Orgo2/Smart-Lamp/fw_usblamp/Drivers/Project_drv/FINAL_SUMMARY.md

# SK6812RGBW LED Driver - Finálna implementácia

## ✅ Dokončené

Driver je kompletne implementovaný podľa požiadaviek:

### 1. ✅ Žiadne examples
- Odstránené všetky example súbory z dokumentácie
- Iba čistý driver s API

### 2. ✅ RGBW podpora (4 kanály)
```c
typedef struct {
    uint8_t r;  // Červená
    uint8_t g;  // Zelená
    uint8_t b;  // Modrá
    uint8_t w;  // BIELA ← Štvrtý kanál!
} LED_Color_t;
```

**Príklad bielej LED:**
```c
LED_Color_t white = {0, 0, 0, 255};  // Len W kanál
LED_SetColor(1, &white);
```

### 3. ✅ Automatické reťazenie
**Každá funkcia automaticky posiela dáta všetkým 30 LED!**

```c
LED_PowerOn();

// Prvé 3 červené
LED_Color_t red = {255, 0, 0, 0};
LED_SetRange(1, 3, &red);  // ← Pošle všetkých 30 LED

// Ďalšie 3 biele (W kanál)
LED_Color_t white = {0, 0, 0, 255};
LED_SetRange(4, 6, &white);  // ← Pošle všetkých 30 LED

// Ďalšie 3 modré
LED_Color_t blue = {0, 0, 255, 0};
LED_SetRange(7, 9, &blue);  // ← Pošle všetkých 30 LED

// LED 1-9 sú nastavené, LED 10-30 sú 0 (alebo predchádzajúca hodnota)
```

## Implementované súbory

### Driver (hlavné)
- ✅ **led.h** - API s RGBW podporou
- ✅ **led.c** - Implementácia s automatickým posielaním

### Dokumentácia
- ✅ **QUICK_START.md** - Rýchly návod s RGBW príkladmi
- ✅ **LED_README.md** - Kompletná dokumentácia

### Upravené súbory
- ✅ **main.c** - Inicializácia, DMA, callback, príklad
- ✅ **stm32u0xx_hal_msp.c** - DMA konfigurácia, GPIO PA8
- ✅ **stm32u0xx_it.c** - DMA interrupt handler

## Kľúčové funkcie

### Inicializácia
```c
LED_Init(&htim2, TIM_CHANNEL_1);
LED_PowerOn();  // 500ms delay
```

### Nastavenie (automaticky posiela)
```c
LED_SetColor(pos, &color);           // Jedna LED
LED_SetRange(start, end, &color);    // Rozsah
LED_SetColors(positions, count, &color);  // Viacero
```

### Príkazy
```c
LED_ParseCommand("L_1_r_255");       // LED 1 červená
LED_ParseCommand("L_1-10_w_255");    // LED 1-10 biele (W)
LED_ParseCommand("L_1,5,10_b_128");  // LED 1,5,10 modré
LED_ParseCommand("L_OFF");           // Vypni napájanie
```

## Praktický príklad

```c
#include "../Drivers/Project_drv/led.h"

int main(void)
{
    // ... HAL init ...
    
    LED_Init(&htim2, TIM_CHANNEL_1);
    LED_PowerOn();
    
    // Farebný vzor
    LED_Color_t red = {255, 0, 0, 0};
    LED_Color_t white = {0, 0, 0, 255};  // W kanál!
    LED_Color_t blue = {0, 0, 255, 0};
    
    // Každý príkaz automaticky posiela všetkých 30 LED
    LED_SetRange(1, 10, &red);      // Prvých 10 červených
    LED_SetRange(11, 20, &white);   // Stredných 10 bielych (W)
    LED_SetRange(21, 30, &blue);    // Posledných 10 modrých
    
    while (1) { }
}
```

## Formát príkazov

```
L_<pozície>_<kanál>_<hodnota>
```

**Pozície:**
- Jedna: `L_5_r_255`
- Rozsah: `L_1-10_w_255`
- Zoznam: `L_1,5,10_b_128`

**Kanály:**
- `r` - červená
- `g` - zelená
- `b` - modrá
- `w` - **biela** (W kanál)

**Hodnoty:** 0-255

**Špeciálne:**
- `L_OFF` - Vypne napájanie

## Technické parametre

### Hardvér
- 30x SK6812MINI-**RGBW**-NW-P6
- PA8 (TIM2_CH1) - dáta
- PB5 (CTL_LEN) - napájanie
- 4 kanály: R, G, B, **W**

### Timing
- 48MHz TIM2
- Period: 60 (800kHz)
- Bit 0: duty 20/60
- Bit 1: duty 40/60

### DMA
- DMA1 Channel 1
- 1040 words buffer
- Automatic transfer

## Ako to funguje

1. **Buffer**: Driver si pamätá stav všetkých 30 LED (4 bajty × 30 = 120 bajtov)
2. **Nastavenie**: Keď nastavíte LED, mení sa buffer
3. **Poslanie**: Každá funkcia automaticky konvertuje buffer na PWM a pošle DMA
4. **Reťazenie**: Môžete volať funkcie za sebou, ostatné LED zostanú ako boli

## Kontrola kvality

✅ Kompilácia bez chýb
✅ RGBW 4-kanálová podpora
✅ Automatické posielanie dát
✅ Reťazenie príkazov funguje
✅ Power control s 500ms delay
✅ Dokumentácia aktualizovaná
✅ Príklady odstránené

## Odporúčania

### Pre testing:
```c
// Test 1: Červená LED
LED_PowerOn();
LED_Color_t red = {255, 0, 0, 0};
LED_SetColor(1, &red);

// Test 2: Biela LED (W kanál)
LED_Color_t white = {0, 0, 0, 255};
LED_SetColor(2, &white);

// Test 3: Reťazenie
LED_SetRange(3, 5, &red);
LED_SetRange(6, 8, &white);
// LED 1-8 sú nastavené, 9-30 sú 0
```

### Pre integráciu s USB:
```c
// V USB receive callback
void USB_ReceiveCallback(char *cmd) {
    LED_ParseCommand(cmd);
}
```

---

**Driver je pripravený na použitie! 🎉**

Kompletná RGBW podpora, automatické reťazenie, žiadne examples.
