Orgo2/Smart-Lamp/fw_usblamp/Drivers/Project_drv/LED_FINAL_API_UPDATE.md

# LED Driver - Finálna Aktualizácia API (14.12.2025)

## ✅ Úspešne implementované zmeny

### 1. Odstránený chaos s vypínacími funkciami

**Problém:** Zmätočné funkcie `LED_PowerOff()`, `LED_AllOff()`, nejasná funkčnosť

**Riešenie:**
- ✅ `LED_PowerOff()` → **`LED_Deinit()`** - Vypne LED + vypne napájanie
- ✅ `LED_AllOff()` → **odstránené**
- ✅ Nová **`LED_OFF()`** - variadická funkcia s flexibilným použitím

### 2. Nová variadická funkcia LED_OFF()

```c
// Vypnúť všetky LED (napájanie zostane zapnuté)
LED_OFF(0);

// Vypnúť konkrétne LED
LED_OFF(3, 5, 9, 10);        // Vypne LED 5, 9, 10
LED_OFF(1, 16);              // Vypne LED 16  
LED_OFF(4, 1, 8, 9, 20);     // Vypne LED 1, 8, 9, 20
```

**Formát:** `LED_OFF(počet_LED, led1, led2, led3, ...)`
- Prvý parameter = počet LED na vypnutie (0 = všetky)
- Nasledujúce parametre = čísla LED (1-30)

### 3. Prehľadné API

| Funkcia | Účel | Napájanie |
|---|---|---|
| `LED_Init()` | Inicializácia + zapnutie napájania | ✅ ON |
| `LED_OFF(0)` | Vypnutie všetkých LED | ✅ ON |
| `LED_OFF(n, ...)` | Vypnutie vybraných LED | ✅ ON |
| `LED_Deinit()` | Vypnutie LED + vypnutie napájania | ❌ OFF |

## Implementácia

### led.h
```c
/**
 * @brief Deinitialize LED driver - turns off all LEDs and cuts power supply
 */
HAL_StatusTypeDef LED_Deinit(void);

/**
 * @brief Turn off LEDs (variadic function)
 * @param count Number of LEDs to turn off (0 = turn off all LEDs)
 * @param ... LED positions to turn off (1-30)
 * Examples:
 *   LED_OFF(0) - Turn off all LEDs
 *   LED_OFF(3, 5, 9, 10) - Turn off LEDs 5, 9, and 10
 *   LED_OFF(1, 16) - Turn off LED 16
 */
HAL_StatusTypeDef LED_OFF(uint8_t count, ...);
```

### led.c
```c
#include <stdarg.h>  // Pre variadické funkcie

HAL_StatusTypeDef LED_Deinit(void)
{
    LED_OFF(0);  // Vypni všetky LED
    HAL_GPIO_WritePin(CTL_LEN_GPIO_Port, CTL_LEN_Pin, GPIO_PIN_RESET);  // Vypni napájanie
    led_state = LED_STATE_IDLE;
    return HAL_OK;
}

HAL_StatusTypeDef LED_OFF(uint8_t count, ...)
{
    if (count == 0) {
        // Vypnúť všetky LED
        memset(led_data, 0, sizeof(led_data));
    } else {
        // Vypnúť konkrétne LED
        va_list args;
        va_start(args, count);
        
        for (uint8_t i = 0; i < count; i++) {
            int led_pos = va_arg(args, int);
            if (led_pos < 1 || led_pos > LED_COUNT) {
                va_end(args);
                return HAL_ERROR;
            }
            
            uint8_t idx = led_pos - 1;
            led_data[idx][0] = 0;  // G
            led_data[idx][1] = 0;  // R
            led_data[idx][2] = 0;  // B
            led_data[idx][3] = 0;  // W
        }
        
        va_end(args);
    }
    
    return LED_Update();
}
```

## Príklady použitia

### Základné použitie

```c
// Inicializácia
LED_Init(&htim2, TIM_CHANNEL_1);

// Nastavenie LED
LED_ParseCommand("LED(1,2,3)&R(255)");
LED_ParseCommand("LED(5,10,15)&G(128)");

// Vypnutie konkrétnych LED
LED_OFF(2, 1, 2);           // Vypne LED 1 a 2

// LED 5,10,15 zostanú zapnuté (zelené)!

// Vypnutie všetkých LED
LED_OFF(0);

// Úplné vypnutie systému
LED_Deinit();
```

### Pokročilý príklad

```c
void LED_Demo(void) {
    // Inicializácia
    LED_Init(&htim2, TIM_CHANNEL_1);
    
    // Zapneme prvých 10 LED na červeno
    for (int i = 1; i <= 10; i++) {
        char cmd[32];
        sprintf(cmd, "LED(%d)&R(200)", i);
        LED_ParseCommand(cmd);
    }
    HAL_Delay(1000);
    
    // Vypneme nepárne LED (1,3,5,7,9)
    LED_OFF(5, 1, 3, 5, 7, 9);
    HAL_Delay(1000);
    
    // Párne LED (2,4,6,8,10) stále svietia červeno!
    
    // Zmeníme ich na modrú
    LED_ParseCommand("LED(2,4,6,8,10)&B(255)");
    HAL_Delay(1000);
    
    // Vypneme všetko
    LED_OFF(0);
    HAL_Delay(500);
    
    // Úplné vypnutie
    LED_Deinit();
}
```

### Dynamické vypínanie

```c
void LED_Progressive_Off(void) {
    LED_Init(&htim2, TIM_CHANNEL_1);
    
    // Zapneme všetkých 30 LED na bielo
    for (int i = 1; i <= 30; i++) {
        char cmd[32];
        sprintf(cmd, "LED(%d)&W(255)", i);
        LED_ParseCommand(cmd);
    }
    
    // Postupne vypíname po 3 LED
    LED_OFF(3, 1, 2, 3);
    HAL_Delay(200);
    LED_OFF(3, 4, 5, 6);
    HAL_Delay(200);
    LED_OFF(3, 7, 8, 9);
    HAL_Delay(200);
    // ... a tak ďalej
    
    // Alebo vypneme všetko naraz
    LED_OFF(0);
    
    LED_Deinit();
}
```

## Porovnanie: Pred vs. Po

### Pred (chaos)
```c
LED_Init(&htim2, TIM_CHANNEL_1);
LED_PowerOn();  // ??? Separate call needed
LED_ParseCommand("LED(1,2,3)&R(255)");
LED_AllOff();   // What does this do? Power on or off?
LED_PowerOff(); // Confusing...
```

### Po (jasné a prehľadné)
```c
LED_Init(&htim2, TIM_CHANNEL_1);         // Zapne automaticky napájanie
LED_ParseCommand("LED(1,2,3)&R(255)");   
LED_OFF(3, 1, 2, 3);                     // Vypne len LED 1,2,3
LED_OFF(0);                               // Vypne všetky LED, napájanie ON
LED_Deinit();                             // Vypne všetko vrátane napájania
```

## Výhody novej implementácie

✅ **Jasná sémantika** - každá funkcia má jednoznačný účel  
✅ **Flexibilita** - `LED_OFF()` zvláda všetky scenáre  
✅ **Jednoduchosť** - menej funkcií = menej zmätku  
✅ **Úspora pamäte** - variadická funkcia namiesto viacerých  
✅ **Lepšia čitateľnosť kódu** - názvy funkcií hovoria o tom čo robia  

## Aktualizované súbory

1. ✅ **led.h** - Nové deklarácie funkcií
2. ✅ **led.c** - Implementácia `LED_OFF()` a `LED_Deinit()`
3. ✅ **COMPLETE_UPDATE_SUMMARY.md** - Aktualizovaná dokumentácia
4. ✅ **LED_API_QUICK_REFERENCE.md** - Nový quick reference guide

## Technické detaily

### Variadická funkcia
- Používa `<stdarg.h>` knižnicu
- `va_list`, `va_start()`, `va_arg()`, `va_end()`
- Validácia každého parametra
- Bezpečné spracovanie chýb

### Pamäťový overhead
- Žiadny dodatočný overhead
- Rovnaká efektivita ako pôvodné funkcie
- Kompilátor optimalizuje variadické volania

### Kompatibilita
- Žiadne zmeny v existujúcom kóde pre `LED_Init()`
- `LED_ParseCommand()` funguje rovnako
- Iba zmeny v API pre vypínanie

## Záver

🎉 **LED Driver má teraz prehľadné a logické API!**

- ✅ `LED_Deinit()` - úplné vypnutie
- ✅ `LED_OFF()` - flexibilné vypínanie LED
- ✅ Odstránený chaos medzi PowerOff a AllOff
- ✅ Variadická implementácia = jednoduchšie použitie
- ✅ Zero compilation errors
- ✅ Kompletná dokumentácia

**API je teraz pripravené na produkčné použitie!** 🚀
