Orgo2/Smart-Lamp/fw_usblamp/Drivers/Project_drv/LED_UPDATE_SUMMARY.md

# LED Driver Update Summary - 2025-12-13

## Changes Implemented

### 1. Merged LED_Init() and LED_PowerOn()
**Problem:** It made no sense to initialize the driver when LED power was off.

**Solution:** 
- `LED_Init()` now automatically turns on the LED power supply
- Waits 500ms for power stabilization
- Clears all LEDs to initial state
- Removed separate `LED_PowerOn()` function

**Before:**
```c
LED_Init(&htim2, TIM_CHANNEL_1);
LED_PowerOn();  // Separate call needed
```

**After:**
```c
LED_Init(&htim2, TIM_CHANNEL_1);  // Power on included!
```

### 2. New Intuitive Command Format
**Problem:** Old format was not user-friendly and didn't support multiple operations easily.

**Solution:** New format: `LED(led_numbers)&COLOR(intensity)`

**Supported Commands:**
1. **Set color and intensity:** `LED(1,5,10)&R(100)`
   - Sets LEDs 1, 5, and 10 to Red with intensity 100
   - Supports R, G, B, W channels
   - Intensity range: 0-255

2. **Turn off specific LEDs:** `LED(1,8,9)&OFF`
   - Turns off LEDs 1, 8, and 9
   - Other LEDs maintain their state

3. **Turn off all LEDs:** `LED(OFF)`
   - Turns off all LEDs
   - Keeps power supply running

### 3. State Management
**Problem:** Driver needed to remember LED states and only update specified LEDs while sending data to all LEDs per datasheet.

**Solution:**
- Driver maintains internal state buffer for all 30 LEDs
- Each command only modifies specified LEDs
- All other LEDs retain their previous state
- Always sends complete data to all 30 LEDs (SK6812RGBW datasheet requirement)

**Example:**
```c
LED_ParseCommand("LED(1)&R(255)");      // LED 1 is Red
LED_ParseCommand("LED(5)&G(128)");      // LED 5 is Green, LED 1 still Red
LED_ParseCommand("LED(10)&B(200)");     // LED 10 is Blue, LEDs 1 and 5 unchanged
LED_ParseCommand("LED(1)&OFF");         // LED 1 off, LEDs 5 and 10 unchanged
```

### 4. Simplified API
**Removed functions:**
- `LED_PowerOn()` - merged into `LED_Init()`
- `LED_SetColor()` - replaced by `LED_ParseCommand()`
- `LED_SetColors()` - replaced by `LED_ParseCommand()`
- `LED_SetRange()` - replaced by `LED_ParseCommand()`
- `LED_Update()` - now private, called automatically

**Kept functions:**
- `LED_Init()` - Enhanced with power on
- `LED_PowerOff()` - Turns off power completely
- `LED_ParseCommand()` - Main interface, new format
- `LED_AllOff()` - Quick clear all LEDs
- `LED_GetState()` - Get driver state
- `LED_TIM_PulseFinishedCallback()` - DMA callback

## Technical Details

### Memory Layout
```c
static uint8_t led_data[LED_COUNT][LED_DATA_SIZE];  // [30 LEDs][G,R,B,W]
```
- Maintains state for all 30 LEDs
- Each LED: 4 bytes (Green, Red, Blue, White)
- Order: GRBW (per SK6812RGBW datasheet)

### Command Parsing
The parser:
1. Validates command format
2. Extracts LED positions (1-30)
3. Extracts color channel and intensity
4. Updates only specified LEDs in state buffer
5. Sends complete buffer to all 30 LEDs via DMA

### Data Transmission
- Uses PWM with DMA
- Sends data to all 30 LEDs every time
- Complies with SK6812RGBW timing requirements
- Reset pulse included automatically

## Usage Examples

### Basic Initialization
```c
// In main.c
LED_Init(&htim2, TIM_CHANNEL_1);
```

### Setting Colors
```c
// Single LED
LED_ParseCommand("LED(1)&R(255)");

// Multiple LEDs same color
LED_ParseCommand("LED(1,5,10,15)&G(128)");

// Different commands for different LEDs
LED_ParseCommand("LED(2,4,6)&B(200)");
LED_ParseCommand("LED(3,5,7)&W(150)");
```

### Turning Off LEDs
```c
// Turn off specific LEDs
LED_ParseCommand("LED(1,2,3)&OFF");

// Turn off all LEDs (keep power on)
LED_ParseCommand("LED(OFF)");

// Turn off power completely
LED_PowerOff();
```

### Dynamic Color Control
```c
char cmd[32];
for (int i = 0; i <= 255; i += 10) {
    sprintf(cmd, "LED(1,2,3,4,5)&R(%d)", i);
    LED_ParseCommand(cmd);
    HAL_Delay(50);
}
```

## Benefits

1. **Simpler Initialization**: One function call instead of two
2. **Intuitive Commands**: Clear, readable format
3. **State Preservation**: LEDs remember their settings
4. **Flexible Control**: Set individual or multiple LEDs
5. **Datasheet Compliance**: Always sends complete data set
6. **Easy Integration**: Simple string-based commands perfect for USB/UART control

## Files Modified

1. **led.h**
   - Updated API documentation
   - Removed obsolete function declarations
   - Added new command format documentation

2. **led.c**
   - Merged `LED_Init()` and `LED_PowerOn()`
   - Completely rewrote `LED_ParseCommand()`
   - Removed `LED_SetColor()`, `LED_SetColors()`, `LED_SetRange()`
   - Made `LED_Update()` private (static)

## Documentation Created

1. **LED_COMMAND_FORMAT.md** - Complete user guide with examples

## Testing Recommendations

Test the following scenarios:

1. **Basic Operations:**
   ```c
   LED_ParseCommand("LED(1)&R(255)");     // Single LED
   LED_ParseCommand("LED(1,5,10)&G(128)"); // Multiple LEDs
   LED_ParseCommand("LED(1)&OFF");         // Turn off one
   LED_ParseCommand("LED(OFF)");           // Turn off all
   ```

2. **State Preservation:**
   ```c
   LED_ParseCommand("LED(1)&R(255)");
   LED_ParseCommand("LED(2)&G(255)");
   // Verify LED 1 is still Red and LED 2 is Green
   ```

3. **Color Mixing:**
   ```c
   LED_ParseCommand("LED(1)&R(100)");
   LED_ParseCommand("LED(1)&G(100)");
   LED_ParseCommand("LED(1)&B(100)");
   // LED 1 should show mixed color (RGB)
   ```

4. **Power Management:**
   ```c
   LED_Init(&htim2, TIM_CHANNEL_1);    // Power on
   LED_ParseCommand("LED(1,2,3)&W(255)");
   LED_PowerOff();                      // Power off
   ```

5. **Error Handling:**
   ```c
   // Test invalid commands
   LED_ParseCommand("LED(50)&R(100)");   // LED 50 doesn't exist
   LED_ParseCommand("LED(1)&X(100)");    // Invalid color
   LED_ParseCommand("LED(1)&R(300)");    // Intensity > 255
   ```

## Migration Guide for Existing Code

If you have existing code using the old API:

**Old Code:**
```c
LED_Init(&htim2, TIM_CHANNEL_1);
LED_PowerOn();

LED_Color_t red = {255, 0, 0, 0};
LED_SetColor(1, &red);

uint8_t positions[] = {5, 10, 15};
LED_SetColors(positions, 3, &red);
```

**New Code:**
```c
LED_Init(&htim2, TIM_CHANNEL_1);  // Power on automatic

LED_ParseCommand("LED(1)&R(255)");
LED_ParseCommand("LED(5,10,15)&R(255)");
```

## Notes

- All LEDs are numbered 1-30 (not 0-29)
- Commands are case-insensitive for color (R/r, G/g, B/b, W/w)
- Driver handles all DMA and timing automatically
- Always check return values for error handling
- Power stabilization delay (500ms) is handled in `LED_Init()`
