Orgo2/Smart-Lamp/suciastky/mic/cmm4030/BOM.txt

3DX_Same_Sky_Supplier: Same Sky
3DX_Same_Sky_Description: 4 x 3 mm, Digital, Top Port, Surface Mount, -26 ±1 dB, MEMS Microphone
3DX_Same_Sky_Model Number: CMM-4030DT-261280-TR
