Orgo2/Smart-Lamp/suciastky/batt/2460.STEP

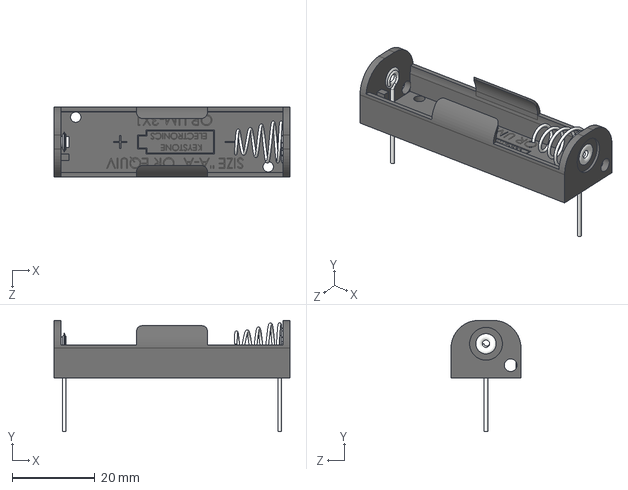
[picture p1: CAD file, 2026-01-05]
suciastky/batt/2460.STEP
57.0 x 26.9 x 16.9 mm
