Orgo2/Smart-Lamp/suciastky/mic/cmm4030/CMM-4030DT-261280-TR.step

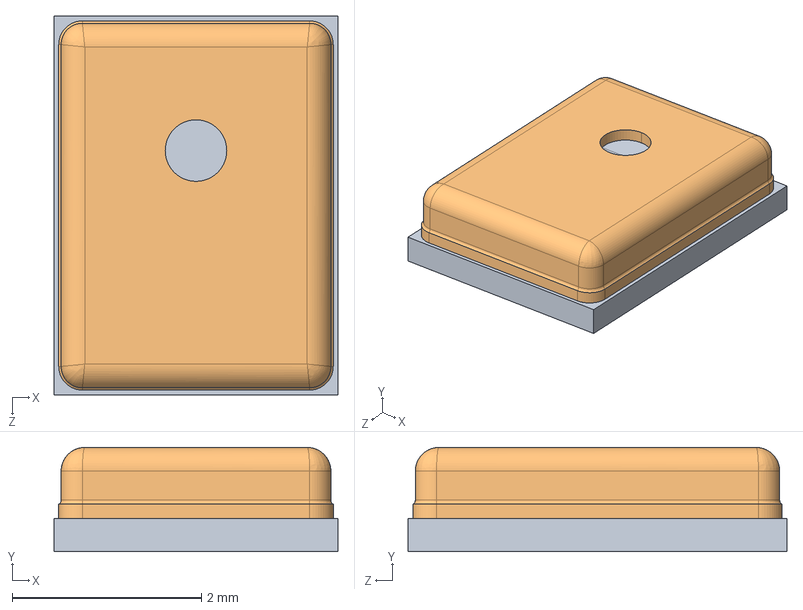
[picture p2: CAD file, 2026-01-05]
suciastky/mic/cmm4030/CMM-4030DT-261280-TR.step
3.00 x 1.10 x 4.00 mm
