Orgo2/Smart-Lamp/suciastky/led/80545_VLMRGB6122-B00_3D_Model.stp

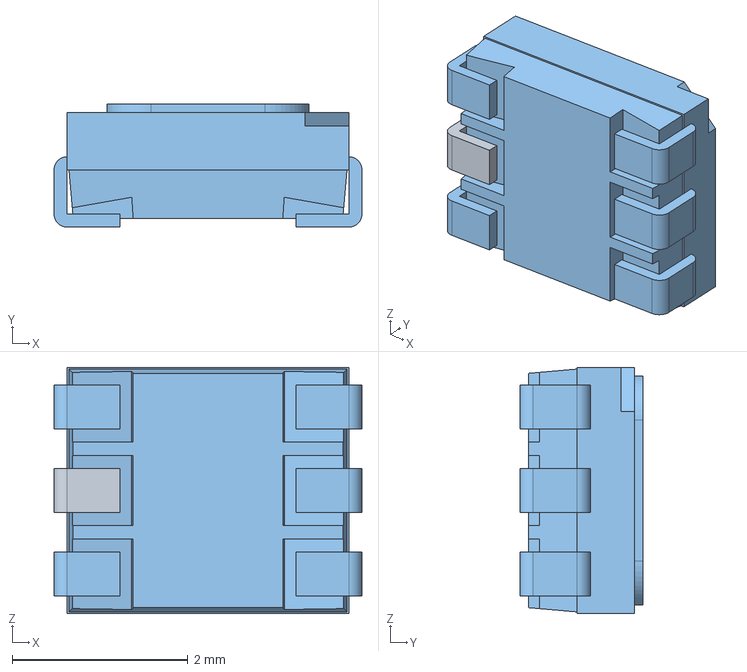
[picture p3: CAD file, 2026-01-05]
suciastky/led/80545_VLMRGB6122-B00_3D_Model.stp
3.50 x 1.40 x 2.80 mm
