Orgo2/Smart-Lamp/lampa_stevko/lampa_stevko.kicad_pcb

## KiCad design lampa_stevko/lampa_stevko.kicad_pcb (2026-01-05)

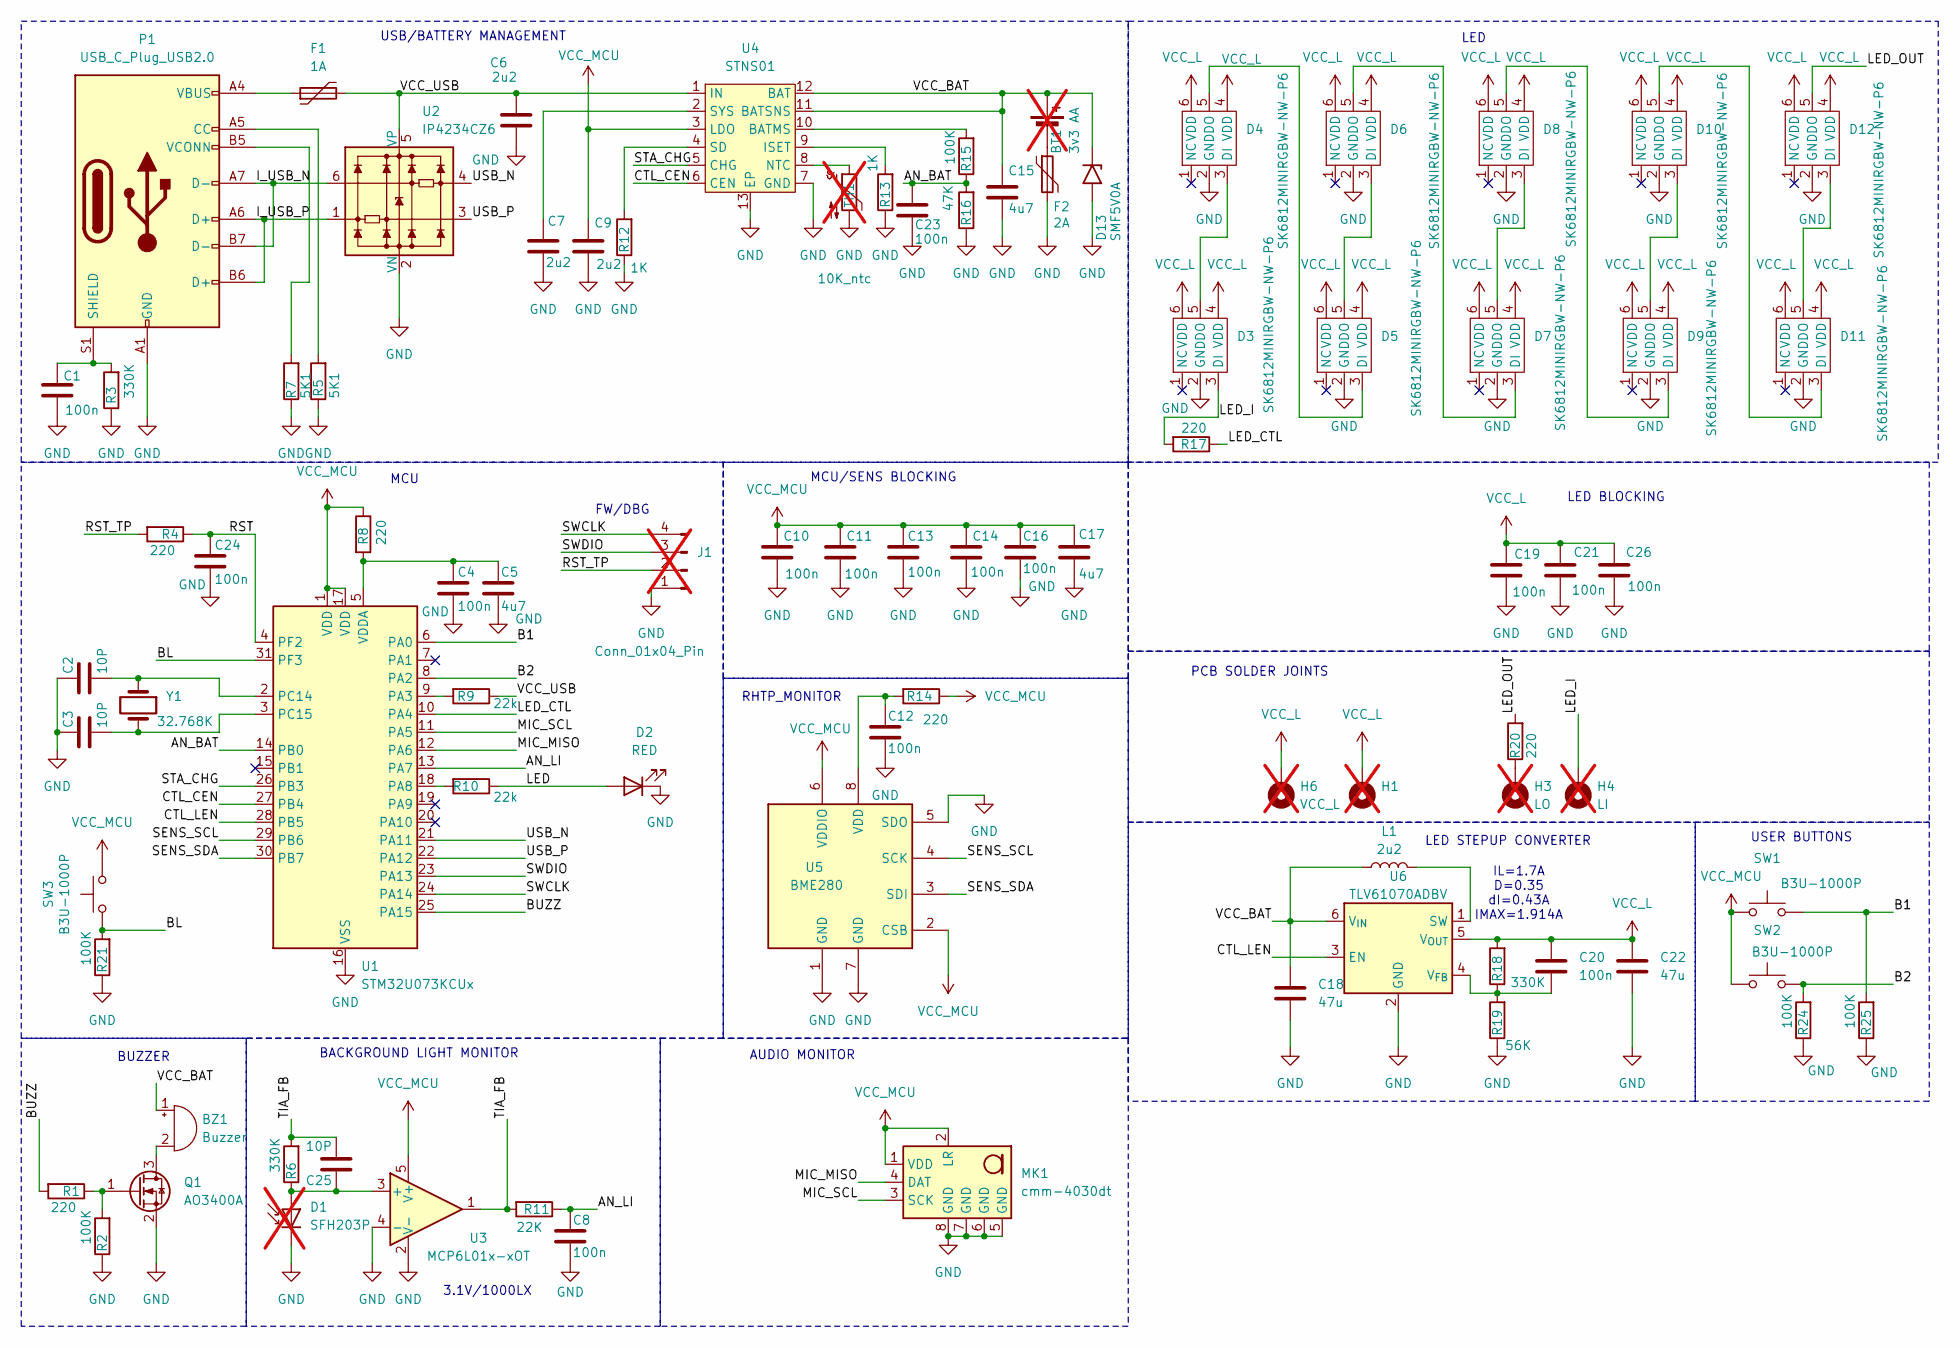
[picture p4: schematic lampa_stevko.kicad_sch]

Parts:
BT1: 3v3 AA; BatteryHolder_Keystone_2460_1xAA; MPN 2460; LCSC C5370863; not fitted
BZ1: Buzzer; Buzzer_CUI_CPT-9019S-SMT; MPN CPT-9019S-SMT-TR; LCSC C95163
C1, C4, C8, C10, C11, C12, C13, C14, C16, C19, C20, C21, C23, C24, C26: 100n; C_0603_1608Metric; MPN CL10B104KO8NNNC; LCSC C66501
C2, C3, C25: 10P; C_0603_1608Metric; MPN CC0603JRNPO8BN100; LCSC C1853175
C5, C15, C17: 4u7; C_0603_1608Metric; MPN CL10A475KP8NNNC; LCSC C1705
C6, C7, C9: 2u2; C_0603_1608Metric; MPN CL10A225KP8NNNC; LCSC C1607
C18, C22: 47u; C_1206_3216Metric; MPN GRM31CR61A476ME15L; LCSC C94034
D1: SFH203P; LED_D3.0mm_Horizontal_O1.27mm_Z6.0mm; MPN SFH 203 P; not fitted
D2: RED; LED_0603_1608Metric; MPN APTD1608LSURCK; LCSC C5342734
D3, D4, D5, D6, D7, D8, D9, D10, D11, D12: SK6812MINIRGBW-NW-P6; LED_RGB_PLCC-6; MPN SK6812MINIRGBW-NW-P6; LCSC C7423107
D13: SMF5V0A; D_SMF; MPN SMF5V0A-E3-08; LCSC C1972946
F1: 1A; R_0603_1608Metric; MPN 0603L100/12AR; LCSC C33977641
F2: 2A; R_0603_1608Metric; MPN JK-SMD0603-200L; LCSC C720073
H1, H6: VCC_L; TestPoint_Pad_2.5x2.5mm; not fitted
H3: LO; TestPoint_Pad_2.5x2.5mm; not fitted
H4: LI; TestPoint_Pad_2.5x2.5mm; not fitted
J1: Conn_01x04_Pin; PinHeader_1x04_P2.54mm_Vertical; not fitted
L1: 2u2; L_1210_3225Metric; MPN DFE322520F-2R2M=P2; LCSC C6021483
MK1: cmm-4030dt; MIC_CMM-4030DT-261280-TR; MPN CMM-4030DT-261075-TR
P1: USB_C_Plug_USB2.0; USB_C_Receptacle_G-Switch_GT-USB-7051x; MPN GT-USB-7051A; LCSC C2843970
Q1: AO3400A; SOT-23; MPN AO3400A; LCSC C49195711
R1, R4, R8, R14, R17, R20: 220; R_0603_1608Metric; MPN RC0603FR-07220RL; LCSC C107696
R2, R15, R21, R24, R25: 100K; R_0603_1608Metric; MPN RC0603FR-07100KL; LCSC C14675
R3, R6, R18: 330K; R_0603_1608Metric; MPN RC0603FR-07330KL; LCSC C114618
R5, R7: 5K1; R_0603_1608Metric; MPN RC0603FR-075K1L; LCSC C105580
R9, R10: 22k; R_0603_1608Metric; MPN RC0603FR-0722KL; LCSC C114065
R11: 22K; R_0603_1608Metric; MPN RC0603FR-0722KL; LCSC C114065
R12, R13: 1K; R_0603_1608Metric; MPN RC0603FR-071KL; LCSC C22548
R16: 47K; R_0603_1608Metric; MPN RC0603FR-0747KL; LCSC C105579
R19: 56K; R_0603_1608Metric; MPN RC0603FR-0756KL; LCSC C114630
SW1, SW2, SW3: B3U-1000P; SW_SPST_B3U-1000P; MPN B3U-1000P; LCSC C231329
TH1: 10K_ntc; R_0603_1608Metric; MPN TH05-3H103F; not fitted
U1: STM32U073KCUx; QFN-32-1EP_5x5mm_P0.5mm_EP3.45x3.45mm; MPN STM32U073KCU6; LCSC C22445363
U2: IP4234CZ6; SC-74-6_1.55x2.9mm_P0.95mm; MPN IP4234CZ6,125; LCSC C455086
U3: MCP6L01x-xOT; SOT-23-5; MPN MCP6L01T-E/OT; LCSC C145745
U4: STNS01; DFN-12-1EP_3x3mm_P0.45mm_EP1.65x2.38mm_ThermalVias; MPN STNS01PUR; LCSC C2848343
U5: BME280; Bosch_LGA-8_2.5x2.5mm_P0.65mm_ClockwisePinNumbering; MPN BME280; LCSC C92489
U6: TLV61070ADBV; SOT-23-6; MPN TLV61070ADBVR; LCSC C6881375
Y1: 32.768K; Crystal_SMD_2012-2Pin_2.0x1.2mm; MPN SC-20S,32.768kHz,20PPM,9pF; LCSC C97603

Connections:
/AN_BAT: C23.1, R15.1, R16.2, U1.14 (PB0)
/AN_LI: C8.1, R11.1, U1.13 (PA7)
/B1: R25.2, SW1.2, U1.6 (PA0)
/B2: R24.2, SW2.2, U1.8 (PA2)
/BL: R21.2, SW3.1, U1.31 (PF3)
/BUZZ: R1.2, U1.25 (PA15)
/CTL_CEN: U1.27 (PB4), U4.6 (CEN)
/CTL_LEN: U1.28 (PB5), U6.3 (EN)
/I_USB_N: P1.A7 (D-), P1.B7 (D-), U2.6
/I_USB_P: P1.A6 (D+), P1.B6 (D+), U2.1
/LED: D2.2 (A), R10.1
/LED_CTL: R17.1, U1.10 (PA4)
/LED_I: D3.3 (DI), H4.1 (MP), R17.2
/LED_OUT: D12.5 (DO), R20.2
/MIC_MISO: MK1.4 (DAT), U1.12 (PA6)
/MIC_SCL: MK1.3 (SCK), U1.11 (PA5)
/RST: C24.1, R4.1, U1.4 (PF2)
/RST_TP: J1.2, R4.2
/SENS_SCL: U1.29 (PB6), U5.4 (SCK)
/SENS_SDA: U1.30 (PB7), U5.3 (SDI)
/STA_CHG: U1.26 (PB3), U4.5 (CHG)
/SWCLK: J1.4, U1.24 (PA14)
/SWDIO: J1.3, U1.23 (PA13)
/TIA_FB: C25.2, R6.2, R11.2, U3.1
/USB_N: U1.21 (PA11), U2.4
/USB_P: U1.22 (PA12), U2.3
/VCC_BAT: BT1.1 (+), BZ1.1 (+), C15.1, C18.1, D13.1 (A1), L1.1, U4.11 (BATSNS), U4.12 (BAT), U6.6 (V_{IN})
/VCC_USB: C6.1, F1.2, R9.1, U2.5 (VP), U4.1 (IN)
GND: C1.2, C2.1, C3.1, C4.2, C5.2, C6.2, C7.2, C8.2, C9.2, C10.2, C11.2, C12.2, C13.2, C14.2, C15.2, C16.2, C17.2, C18.2, C19.2, C21.2, C22.2, C23.2, C24.2, C26.2, D1.1 (K), D2.1 (K), D3.2 (GND), D4.2 (GND), D5.2 (GND), D6.2 (GND), D7.2 (GND), D8.2 (GND), D9.2 (GND), D10.2 (GND), D11.2 (GND), D12.2 (GND), D13.2 (A2), F2.2, J1.1, MK1.5 (GND), MK1.6 (GND), MK1.7 (GND), MK1.8 (GND), P1.A1 (GND), P1.A12 (GND), P1.B1 (GND), P1.B12 (GND), Q1.2 (S), R2.1, R3.1, R5.1, R7.1, R12.1, R13.1, R16.1, R19.1, R21.1, R24.1, R25.1, TH1.2, U1.16 (VSS), U1.32 (VSS), U1.33 (VSS), U2.2 (VN), U3.2 (V-), U3.4 (-), U4.7 (GND), U4.13 (EP), U5.1 (GND), U5.5 (SDO), U5.7 (GND), U6.2 (GND)
unnamed: BT1.2 (-), F2.1
unnamed: BZ1.2 (-), Q1.3 (D)
unnamed: C25.1, D1.2 (A), R6.1, U3.3 (+)
unnamed: D3.5 (DO), D4.3 (DI)
unnamed: D4.5 (DO), D5.3 (DI)
unnamed: D5.5 (DO), D6.3 (DI)
unnamed: D6.5 (DO), D7.3 (DI)
unnamed: D7.5 (DO), D8.3 (DI)
unnamed: D8.5 (DO), D9.3 (DI)
unnamed: D9.5 (DO), D10.3 (DI)
unnamed: D10.5 (DO), D11.3 (DI)
unnamed: D11.5 (DO), D12.3 (DI)
unnamed: F1.1, P1.A4 (VBUS), P1.A9 (VBUS), P1.B4 (VBUS), P1.B9 (VBUS)
unnamed: H3.1 (MP), R20.1
unnamed: P1.A5 (CC), R5.2
unnamed: C1.1, P1.S1 (SHIELD), R3.2
unnamed: P1.B5 (VCONN), R7.2
unnamed: Q1.1 (G), R1.1, R2.2
unnamed: R9.2, U1.9 (PA3)
unnamed: R10.2, U1.18 (PA8)
unnamed: C2.2, U1.2 (PC14), Y1.1
unnamed: C3.2, U1.3 (PC15), Y1.2
unnamed: C4.1, C5.1, R8.2, U1.5 (VDDA)
unnamed: R15.2, U4.10 (BATMS)
unnamed: R13.2, U4.9 (ISET)
unnamed: TH1.1, U4.8 (NTC)
unnamed: R12.2, U4.4 (SD)
unnamed: C7.1, U4.2 (SYS)
unnamed: C12.1, R14.2, U5.8 (VDD)
unnamed: L1.2, U6.1 (SW)
unnamed: C20.2, R18.1, R19.2, U6.4 (V_{FB})
VCC_L: C19.1, C20.1, C21.1, C22.1, C26.1, D3.4 (VDD), D3.6 (VDD), D4.4 (VDD), D4.6 (VDD), D5.4 (VDD), D5.6 (VDD), D6.4 (VDD), D6.6 (VDD), D7.4 (VDD), D7.6 (VDD), D8.4 (VDD), D8.6 (VDD), D9.4 (VDD), D9.6 (VDD), D10.4 (VDD), D10.6 (VDD), D11.4 (VDD), D11.6 (VDD), D12.4 (VDD), D12.6 (VDD), H1.1 (MP), H6.1 (MP), R18.2, U6.5 (V_{OUT})
VCC_MCU: C9.1, C10.1, C11.1, C13.1, C14.1, C16.1, C17.1, MK1.1 (VDD), MK1.2 (LR), R8.1, R14.1, SW1.1, SW2.1, SW3.2, U1.1 (VDD), U1.17 (VDD), U3.5 (V+), U4.3 (LDO), U5.2 (CSB), U5.6 (VDDIO)

Notes on the sheet:
USER BUTTONS
PCB SOLDER JOINTS
BACKGROUND LIGHT MONITOR
FW/DBG
AUDIO MONITOR
BUZZER
3.1V/1000LX
MCU
RHTP_MONITOR
IL=1.7A D=0.35 dI=0.43A IMAX=1.914A
MCU/SENS BLOCKING
LED BLOCKING
LED STEPUP CONVERTER
LED
USB/BATTERY MANAGEMENT

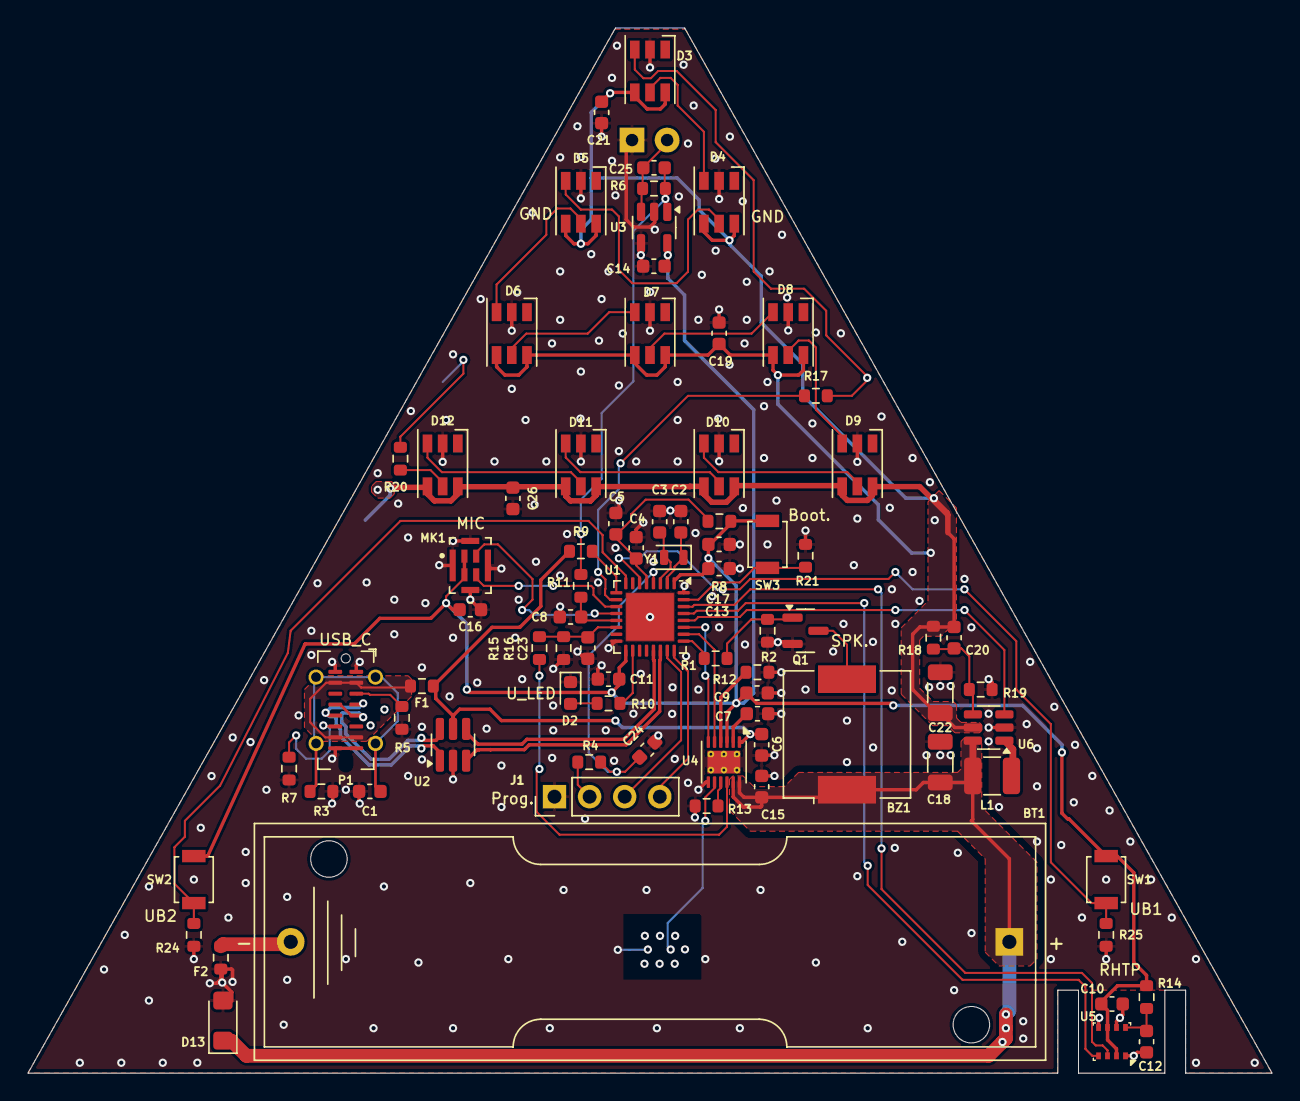
[picture p5: board lampa_stevko.kicad_pcb from above]

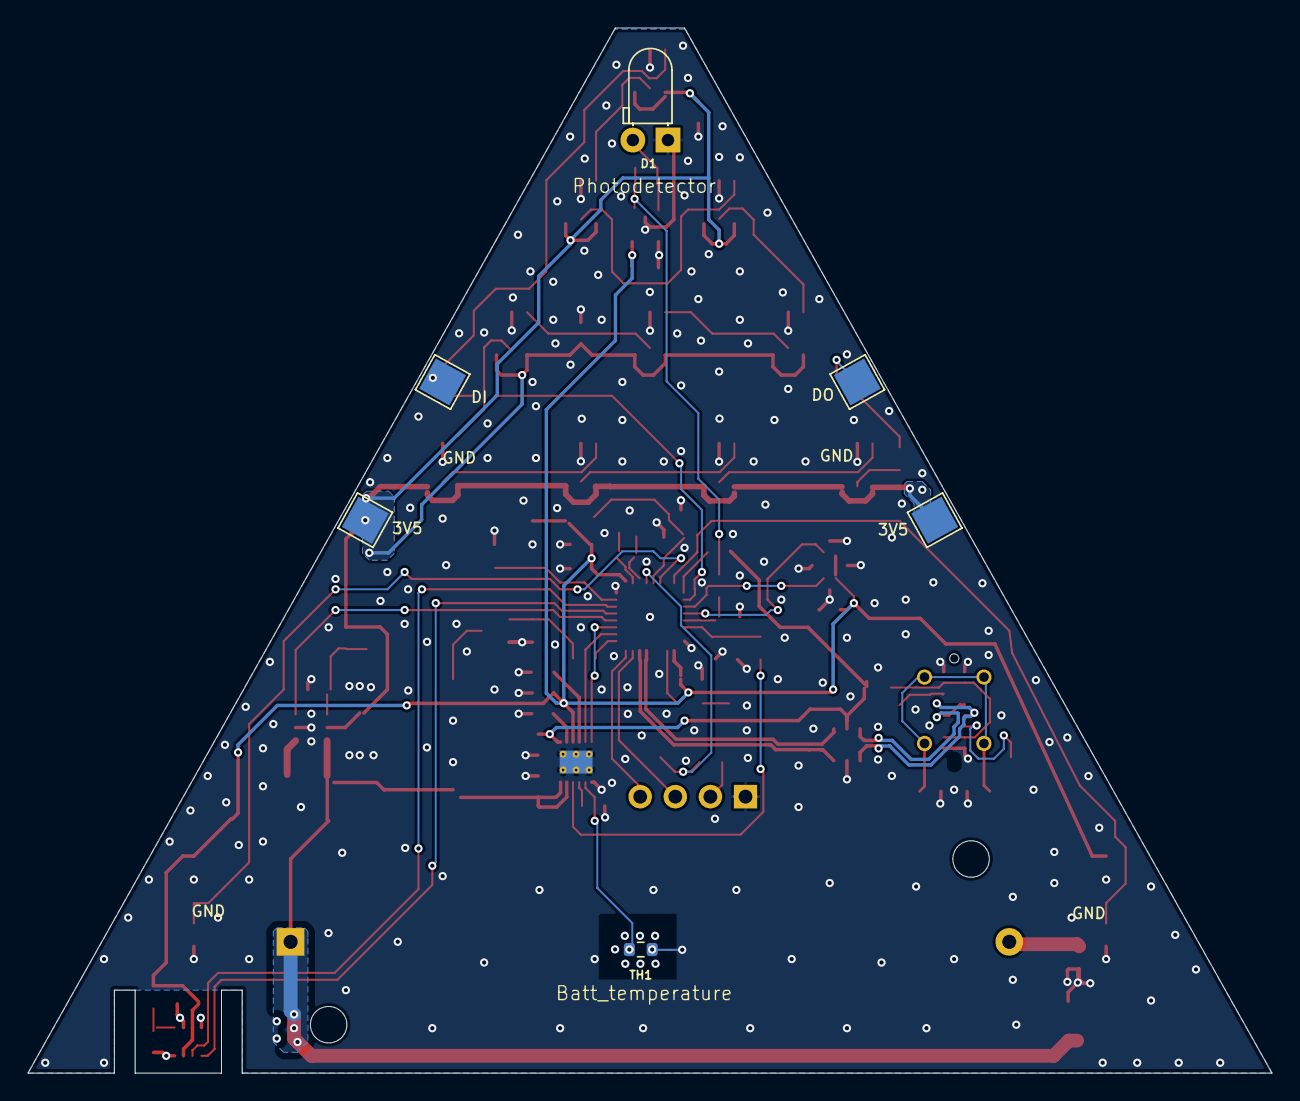
[picture p6: board lampa_stevko.kicad_pcb from below]

Board: 4 copper layers, 90.0 x 75.6 mm, 86 parts (6 on the bottom side), 62 nets.
