Orgo2/Smart-Lamp/fw_usblamp/Core/Inc/main.h

#define B1_Pin GPIO_PIN_0
#define B1_GPIO_Port GPIOA
#define B2_Pin GPIO_PIN_2
#define B2_GPIO_Port GPIOA
#define USB_Pin GPIO_PIN_3
#define USB_GPIO_Port GPIOA
#define BUZZ_Pin GPIO_PIN_4
#define BUZZ_GPIO_Port GPIOA
#define AN_LIGHT_Pin GPIO_PIN_7
#define AN_LIGHT_GPIO_Port GPIOA
#define AN_BATT_Pin GPIO_PIN_0
#define AN_BATT_GPIO_Port GPIOB
#define LED_Pin GPIO_PIN_8
#define LED_GPIO_Port GPIOA
#define CTL_LED_Pin GPIO_PIN_15
#define CTL_LED_GPIO_Port GPIOA
#define STA_CHG_Pin GPIO_PIN_3
#define STA_CHG_GPIO_Port GPIOB
#define CTL_CEN_Pin GPIO_PIN_4
#define CTL_CEN_GPIO_Port GPIOB
#define CTL_LEN_Pin GPIO_PIN_5
#define CTL_LEN_GPIO_Port GPIOB
#define BL_Pin GPIO_PIN_3
#define BL_GPIO_Port GPIOF
#define IND_LED_ON_LEVEL  GPIO_PIN_SET
#define IND_LED_OFF_LEVEL GPIO_PIN_RESET
