Orgo2/Smart-Lamp/fw_usblamp/USBX/App/ux_device_cdc_acm.c

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

/* Includes ------------------------------------------------------------------*/
#include "ux_device_cdc_acm.h"

/* USER CODE BEGIN PV */
UX_SLAVE_CLASS_CDC_ACM  *cdc_acm=NULL;
/* USER CODE END PV */

/**
  * @brief  USBD_CDC_ACM_Activate
  *         This function is called when insertion of a CDC ACM device.
  * @param  cdc_acm_instance: Pointer to the cdc acm class instance.
  * @retval none
  */
VOID USBD_CDC_ACM_Activate(VOID *cdc_acm_instance)
{
  /* USER CODE BEGIN USBD_CDC_ACM_Activate */
  UX_PARAMETER_NOT_USED(cdc_acm_instance);
  cdc_acm = (UX_SLAVE_CLASS_CDC_ACM *)cdc_acm_instance;
  /* USER CODE END USBD_CDC_ACM_Activate */

  return;
}

/**
  * @brief  USBD_CDC_ACM_Deactivate
  *         This function is called when extraction of a CDC ACM device.
  * @param  cdc_acm_instance: Pointer to the cdc acm class instance.
  * @retval none
  */
VOID USBD_CDC_ACM_Deactivate(VOID *cdc_acm_instance)
{
  /* USER CODE BEGIN USBD_CDC_ACM_Deactivate */
  UX_PARAMETER_NOT_USED(cdc_acm_instance);
  cdc_acm = UX_NULL;
  /* USER CODE END USBD_CDC_ACM_Deactivate */

  return;
}

/**
  * @brief  USBD_CDC_ACM_ParameterChange
  *         This function is invoked to manage the CDC ACM class requests.
  * @param  cdc_acm_instance: Pointer to the cdc acm class instance.
  * @retval none
  */
VOID USBD_CDC_ACM_ParameterChange(VOID *cdc_acm_instance)
{
  /* USER CODE BEGIN USBD_CDC_ACM_ParameterChange */
  UX_PARAMETER_NOT_USED(cdc_acm_instance);
  /* USER CODE END USBD_CDC_ACM_ParameterChange */

  return;
}

/* USER CODE BEGIN 1 */
uint32_t USBD_CDC_ACM_Transmit(uint8_t* buffer, uint32_t size, uint32_t* sent)
{
    if (sent) *sent = 0;
    if (cdc_acm == NULL)
    {
        return 1; /* not connected */
    }

    /* Non-blocking with timeout: never hang the firmware if host isn't reading. */
    ULONG start = _ux_utility_time_get();
    UINT retVal;

    do
    {
        retVal = ux_device_class_cdc_acm_write_run(cdc_acm, buffer, size, sent);

        if (retVal == UX_STATE_NEXT)
        {
            return 0; /* sent OK */
        }

        /* If class wants us to try again later, don't spin forever. */
        if ((_ux_utility_time_get() - start) > 20U)
        {
            return 2; /* busy/timeout */
        }

    } while (retVal == UX_STATE_WAIT || retVal == UX_STATE_LOCK);

    /* Any other code is treated as an error / not ready. */
    return 2;
}

uint32_t USBD_CDC_ACM_Receive(uint8_t* buffer, uint32_t size, uint32_t* received)
{
  if (received) *received = 0;
  if (cdc_acm!=NULL){
    ux_device_class_cdc_acm_read_run(cdc_acm,buffer,size,received);
    return 0;
  }else{
   return 1;
  }

}
/* USER CODE END 1 */
