Orgo2/Smart-Lamp/fw_usblamp/Drivers/Project_drv/led.h

/*
 * led.h
 */

#ifndef PROJECT_DRV_LED_H_
#define PROJECT_DRV_LED_H_

#include "stm32u0xx_hal.h"
#include <stdint.h>

void led_set_RGB(uint8_t index, uint8_t r, uint8_t g, uint8_t b);
void led_set_RGBW(uint8_t index, uint8_t r, uint8_t g, uint8_t b, uint8_t w);
void led_set_all_RGB(uint8_t r, uint8_t g, uint8_t b);
void led_set_all_RGBW(uint8_t r, uint8_t g, uint8_t b, uint8_t w);
void led_render(void);

#endif
