Orgo2/Smart-Lamp/(commit log)

2026-01-05 first commit, schematic 3 bugs and programming pascal interpretter with eeprom memory acess missing. mems mic not working yet(HW?)
    [2460.STEP, 80545_VLMRGB6122-B00_3D_Model.stp, CMM-4030DT-261280-TR.step, Same_Sky_CMM-4030DT-261280-TR.step, bom.csv, bom_led.csv, designators.csv, lampa_stevko.csv]
2026-01-15 prepinanie pamati-b1nastavit dlhsie ako 2s mic debbug pouzity no mic nejde bootloader neopraveny inak to vyzera dobre
    [lampa_stevko.kicad_sch]
2026-01-21 button reading fixed, program can be edited, ram monitor added coments fixed/translated
    [LAMP_USB.ioc, MiniPascal.c, MiniPascal.h, alarm.c, alarm.h, analog.c, analog.h, bme280.c]
2026-01-23 lamp test done-button fixed, b2sleep, mem shows runtime
    [MiniPascal.c, MiniPascal.h, led.c, led.h, main.c]
2026-01-26 opravene kodovacie bugy-znova sa da programovat. rozsirena pamat na 70riadkov kodu, debug led zavedena, pridana moznost komentarov, ochrana pred 1v5 nabijanim. mic a fft pridane
    [LAMP_USB.ioc, MiniPascal.c, MiniPascal.h, alarm.c, alarm.h, analog.c, analog.h, bme280.c]
2026-01-30 firmware updated to 6 memory slots, mic fixed, mic calibration and autocalibration added, beeper fixed, dynamic user variable slots
    [LAMP_USB.ioc, MiniPascal.c, MiniPascal.h, main.c, mic.h]
