Orgo2/Smart-Lamp/(notices)

Notices in the files:
fw_usblamp/USBX/App/ux_device_descriptors.h:
Copyright (c) 2025 STMicroelectronics.
All rights reserved.
This software is licensed under terms that can be found in the LICENSE file
